rx178nwj/SteppingMotorDriver/firmware_test/param_design_notes.md

# パラメータ設計ノート

## 物理制約からの推定範囲

### 前提
- モータードライバ: DRV8825
- 電源: 24V
- 典型的なステッピングモーター: NEMA17 (200 steps/rev, 1.8°/step)
- RMT 解像度: 1 MHz (1 µs)

---

## マイクロステップと実回転速度

| マイクロステップ | steps/rev | 1000 steps/sec | 5000 steps/sec | 10000 steps/sec |
|:---:|---:|---:|---:|---:|
| 1/1  | 200 | 300 RPM | 1500 RPM | 3000 RPM |
| 1/2  | 400 | 150 RPM |  750 RPM | 1500 RPM |
| 1/4  | 800 |  75 RPM |  375 RPM |  750 RPM |
| 1/8  | 1600  |  37 RPM |  188 RPM |  375 RPM |
| 1/16 | 3200  |  19 RPM | 94 RPM |  188 RPM |
| 1/32 | 6400  | 9 RPM | 47 RPM | 94 RPM |

ロボットアーム用途の実用域: **10〜150 RPM** 前後

---

## マイクロステップ選択の指針

| 設定 | トルク | 滑らかさ | 共振リスク | 推奨用途 |
|---|:---:|:---:|:---:|---|
| 1/1  | ★★★★★ | ★ | 高い | 高トルク低速位置決め |
| 1/2  | ★★★★  | ★★ | 中 | |
| 1/4  | ★★★ | ★★★ | 中 | |
| 1/8  | ★★★ | ★★★★ | 低い | **バランス重視（推奨候補）** |
| 1/16 | ★★ | ★★★★★ | 低い | **静粛性重視（推奨候補）** |
| 1/32 | ★★ | ★★★★★ | 低い | 超低速精密動作 |

DRV8825 + 24V の場合、**1/8〜1/16** が実用的なトルク×スムーズさのバランス点。

---

## 最大速度 (vmax) の目安

ステッピングモーターは高速になるほどトルクが低下する。
24V 駆動の NEMA17 の場合、概ね以下の範囲で脱調リスクが増大する:

| マイクロステップ | 安全域 (低リスク) | 上限目安 | RMT 上限 |
|:---:|---:|---:|---:|
| 1/1  | ≤ 3000 steps/sec | 6000 | 200000 |
| 1/2  | ≤ 5000 steps/sec | 10000 | 200000 |
| 1/4  | ≤ 8000 steps/sec | 16000 | 200000 |
| 1/8  | ≤ 5000 steps/sec | 10000 | 200000 |
| 1/16 | ≤ 5000 steps/sec | 10000 | 200000 |
| 1/32 | ≤ 3000 steps/sec | 6000  | 200000 |

※ 実際のモーター仕様・負荷・電流設定により大きく変動する。スイープで実測すること。

---

## 加速度 (accel/decel) の目安

加速度が大きすぎると起動・停止時に脱調する。

```
必要ステップ数 = vmax² / (2 × accel)

例: vmax=2000, accel=1000 → 停止距離 = 2000² / (2×1000) = 2000 steps
```

| accel [steps/sec²] | vmax=1000 の加速距離 | vmax=5000 の加速距離 |
|---:|---:|---:|
| 200 | 2500 steps | 62500 steps |
| 500 | 1000 steps | 25000 steps |
| 1000  |  500 steps | 12500 steps |
| 2000  |  250 steps |  6250 steps |
| 5000  |  100 steps |  2500 steps |
| 10000 | 50 steps |  1250 steps |

加速距離が TEST_STEPS (3200) より大きい場合は三角プロファイルになる（最高速未達）。

---

## スイープテスト戦略

### Phase 1: マイクロステップ選択
```
accel=1000 固定, vmax=2000 固定
microstep を 1,2,4,8,16,32 で切り替えて動作音・振動を確認
```
→ 最も滑らかに動作するマイクロステップを選択

### Phase 2: 最大速度探索（選択したマイクロステップで）
```
python param_sweep.py COM3 --find-max-speed --microstep 16 --accel 1000
```
→ 脱調しない最大速度を確認

### Phase 3: 加速度最適化（選択した vmax で）
```
python param_sweep.py COM3 --quick
```
→ 最大速度で脱調しない最大加速度を確認

### Phase 4: NVS に保存
```
SET MICROSTEP 16
SET VMAX 0 <最大速度 × 0.8>   ← 安全マージン 20%
SET ACCEL 0 <最大加速度 × 0.8>
SET DECEL 0 <最大加速度 × 0.8>
SAVE
```

---

## 現在のデフォルト値

| パラメータ | デフォルト | ファームウェア上限 |
|---|---:|---:|
| vmax | 1000 steps/sec | 200000 |
| accel | 500 steps/sec² | (無制限) |
| decel | 500 steps/sec² | (無制限) |
| microstep | 1/32 | — |

デフォルトは保守的。実機テストで引き上げること。
