rx178nwj/SteppingMotorDriver/firmware/CODEX_PROMPT_BLE_PHASE5.md

# Codex 実装プロンプト — SteppingMotorDriver firmware BLE/WiFiテレメトリ Phase 5

## 役割
あなたは ESP-IDF（ESP32-S3）ファームウェアの実装・検証を担当するエンジニアです。
SteppingMotorDriver ファームウェアの無線テレメトリ機能 **Phase 5**（統合テスト：BLE/WiFi同時有効時の
coexistence評価、実機アンテナ性能評価）を、本リポジトリ内の要件定義書に厳密に従って実施してください。

**前提条件：Phase 2（BLEペアリング）・Phase 4（WiFi TCPテレメトリ）が完了していること。**
未完了の場合は着手せず、その旨を報告してください。

本Phaseは新機能の実装ではなく、**既存実装（Phase 1〜4）の検証・評価が中心**です。評価の結果、
リアルタイム性・安全性に影響する問題が見つかった場合のみ、最小限の修正を行ってください。

## 参照ドキュメント（正）
- `SteppingMotorDriver/firmware/BLE_WIFI_REQUIREMENTS.md` §7.1（安全性、最重要）・§7.3（無線共存）・
  §7.4（リアルタイム性）・§9.3（BLE/WiFi同時有効時の実機ジッタ許容量、未解決事項）・
  §9.5（筐体内アンテナ性能、未解決事項）
- `SteppingMotorDriver/firmware/REQUIREMENTS.md` §5.1（既存のリアルタイム性要件、モーション制御タスクの
  タイミング制約）
- 既存の統合テスト資産：`SteppingMotorDriver/firmware_test/`（既存105/106 PASSのテスト構成を参考に、
  同様の形式でBLE/WiFi統合テストケースを追加する）

## 今回のスコープ（Phase 5）
1. BLE/WiFi同時有効時のcoexistence評価（§7.3、§9.3の解消）
2. 実機アンテナ性能評価（§3、§9.5の解消）
3. 安全性の最終確認（§7.1：無線経由の書き込みコマンドが一切受理されないことの網羅的検証）
4. リアルタイム性の回帰確認（§7.4：BLE/WiFi有効化がモーション制御のタイミングに影響しないこと）

## Phase 5 実施要件（詳細）

### 4-A. coexistence評価（§7.3、§9.3）
- BLE・WiFi両方を同時有効化した状態で、以下を実機計測する：
  - BLE Notify（Axis Status、10Hz）の遅延・ジッタ・欠落率
  - WiFi TCPテレメトリ配信のレイテンシ・ジッタ・欠落率（配信レート1Hz/10Hz/100Hzでそれぞれ計測）
  - 既存のモーション制御タイミング（RMTパルス周期、`MotorControlTask`の1ms周期の遵守）に乱れがないか
- 典型運用として「BLEのみ」「WiFiのみ」「両方同時」の3パターンで比較し、許容可能なジッタ量を評価する。
- 評価結果を`BLE_WIFI_REQUIREMENTS.md` §9.3に追記し、未解決事項をクローズする（問題があれば推奨運用
  構成を明記する。両方同時有効化を禁止するかどうかもこの評価結果を根拠に判断する）。

### 4-B. アンテナ性能評価（§3、§9.5）
- 実機筐体（金属筐体・他基板との近接配置）でのBLE Advertising到達距離・WiFi RSSI・接続安定性を計測する。
- 評価結果を`BLE_WIFI_REQUIREMENTS.md` §9.5に追記し、未解決事項をクローズする（問題があれば筐体設計・
  アンテナ配置の改善提案を記録する。ハードウェア変更が必要な場合は本Phaseでは実施せず、課題として
  記録するのみでよい）。

### 4-C. 安全性の最終確認（§7.1、最重要・必須）
- BLE・WiFiいずれの経路からも、モーション制御・設定変更コマンドが一切受理されないことを網羅的に検証する：
  - BLE：書き込み可能なキャラクタリスティックが存在しないこと（CCCD以外）をGATTサービス定義から確認する
  - WiFi：TCP接続経由で送信したデータが一切コマンドとして解釈されないことを実機で確認する（Phase 4で
    実装済みのはずだが、本Phaseで独立した検証として再確認する）
  - ESTOPを含むモーション制御操作がBLE/WiFi経由で一切発行できないことを確認する
- この検証で問題が見つかった場合は**最優先で修正**すること（本Phaseの他の評価作業より優先する）。

### 4-D. リアルタイム性の回帰確認（§7.4）
- 既存の統合テスト（`firmware_test/`）が、BLE/WiFi有効化状態でも回帰なくPASSすることを確認する。
- モーション制御のタイミング（脱調検出、ホーミング精度等）にBLE/WiFiタスクが影響を与えていないことを
  既存テストケースの実行結果で確認する。

## 成果物
- coexistence評価・アンテナ性能評価の結果レポート（`BLE_WIFI_REQUIREMENTS.md` §9.3/§9.5への追記、
  未解決事項のクローズ）
- 評価で発見された問題への最小限の修正（あれば）
- 必要に応じて`firmware_test/`へのBLE/WiFi統合テストケース追加

## 完了条件（Definition of Done）
- BLE/WiFi同時有効時のcoexistence評価が完了し、推奨運用構成が`BLE_WIFI_REQUIREMENTS.md` §9.3に
  記録されている
- アンテナ性能評価が完了し、結果が§9.5に記録されている
- §7.1の安全性要件（無線経由の書き込みコマンド不受理）が実機で網羅的に確認されている
- 既存の統合テストが回帰なくPASSすることを確認している
- 実機評価ができない場合は、どこまで確認できたか・何が未確認かを明確に報告すること
