rx178nwj/SteppingMotorDriver/firmware_test/sweep_result_20260531_152136.csv

microstep | vmax | accel | passed | pos_error | elapsed_ms | note
8 | 500 | 500 | False | 0 | 0.0 | GET POS failed
8 | 500 | 1000 | False | 0 | 0.0 | GET POS failed
8 | 500 | 2000 | False | 0 | 0.0 | GET POS failed
8 | 500 | 5000 | False | 0 | 0.0 | GET POS failed
8 | 1000 | 500 | False | 0 | 0.0 | GET POS failed
8 | 1000 | 1000 | False | 0 | 0.0 | final GET POS failed
8 | 1000 | 2000 | False | 0 | 0.0 | GET POS failed
8 | 1000 | 5000 | False | 0 | 0.0 | GET POS failed
8 | 2000 | 500 | False | 0 | 0.0 | GET POS failed
8 | 2000 | 1000 | False | 0 | 0.0 | GET POS failed
8 | 2000 | 2000 | False | 0 | 0.0 | GET POS failed
8 | 2000 | 5000 | False | 0 | 0.0 | GET POS failed
8 | 5000 | 500 | False | 0 | 0.0 | final GET POS failed
8 | 5000 | 1000 | False | 0 | 0.0 | GET POS failed
8 | 5000 | 2000 | False | 0 | 0.0 | GET POS failed
8 | 5000 | 5000 | False | 0 | 0.0 | GET POS failed
8 | 10000 | 500 | False | 0 | 0.0 | GET POS failed
8 | 10000 | 1000 | False | 0 | 0.0 | GET POS failed
8 | 10000 | 2000 | False | 0 | 0.0 | GET POS failed
8 | 10000 | 5000 | False | 0 | 0.0 | GET POS failed
16 | 500 | 500 | False | 0 | 0.0 | GET POS failed
16 | 500 | 1000 | False | 0 | 0.0 | final GET POS failed
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
