rx178nwj/SteppingMotorDriver/(list of files, drawings)

Other design files:
schematic/SteppingMotorDriver.dsn
