rx178nwj/SteppingMotorDriver/(commit log)

2026-05-04 Initial KiCad stepper driver design
    [SteppingMotorDriver.kicad_pcb, SteppingMotorDriver.kicad_sch, adc_io.kicad_sch, drivers.kicad_sch, encoders_io.kicad_sch, mcu_usb.kicad_sch, power.kicad_sch]
2026-05-09 Refactor: reorganize into schematic/, firmware/, firmware_test/ structure
    [SteppingMotorDriver-B_Cu.gbr, SteppingMotorDriver-B_Mask.gbr, SteppingMotorDriver-B_Paste.gbr, SteppingMotorDriver-B_Silkscreen.gbr, SteppingMotorDriver-Edge_Cuts.gbr, SteppingMotorDriver-F_Cu.gbr, SteppingMotorDriver-F_Mask.gbr, SteppingMotorDriver-F_Paste.gbr]
2026-05-10 Add firmware skeleton and update schematic: DIP switch removed, MS lines GPIO-driven
    - MS0/MS1/MS2 now driven by ESP32-S3 GPIO (GPIO22/23/24) with 100Ω series resistors
    - Remove DIP switch from schematic plan and PCB
    - Add firmware scaffold: main, motor_ctrl, comm, config modules with sdkconfig
    - Add CLAUDE.md project instructions and .gitignore
    - Remove stale DRC/session files (SteppingMotorDriver.rules, .ses)
    [SteppingMotorDriver.kicad_pcb, mcu_usb.kicad_sch]
2026-05-30 Fix: move rmt_transmit() out of ISR context to prevent motor stall
    on_trans_done was calling rmt_transmit() from ISR, but rmt_transmit()
    internally uses xQueueSend() which is not ISR-safe. This caused only the
    first 5-pulse batch (RMT_LOOP_COUNT) to be sent, leaving the motor
    energized but stationary (humming).
    - on_trans_done: remove rmt_transmit() call; update step_pos only
    - motor_control_task: call rmt_kick() from task context every 1ms tick
    (trans_queue_depth=4 absorbs bursts; full-queue errors are ignored)
    - start_motion: reject motion if DRV not enabled (ENABLE not called)
    [motor_ctrl.c]
2026-06-19 Redesign schematic to 3ch: DRV8825x3, AM26LV32 differential encoder, swap ADC3/ADC4
    - DRV8825 stepper driver: 4ch -> 3ch (STEP/DIR CH0-2 on GPIO6-11)
    - Encoder: 3ch differential input via AM26LV32IDR for Stepperonline 17HS15-1504-ME1K (1000PPR)
    - A+/A-, B+/B-, Z+/Z- differential pairs, GPIO15-17/18/21/35/36-37/40
    - ADC assignment swap: GPIO4=MOT_V(ADC3) voltage monitor, GPIO5=CURRENT(ADC4) 100mOhm+20x amp
    - Updated Gerber files (Gerber202960613 replaces Gerber202960504)
    - Added AM26LV32IDR and AM26C32INSR library files
    - Updated REQUIREMENTS.md: 3ch axis range, encoder specs, ADC channel table, current conversion formula
    - Updated CLAUDE.md: corrected GPIO4/5 signal assignments and startup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
    [SteppingMotorDriver-B_Cu.gbr, SteppingMotorDriver-B_Mask.gbr, SteppingMotorDriver-B_Paste.gbr, SteppingMotorDriver-B_Silkscreen.gbr, SteppingMotorDriver-Edge_Cuts.gbr, SteppingMotorDriver-F_Cu.gbr, SteppingMotorDriver-F_Mask.gbr, SteppingMotorDriver-F_Paste.gbr]
2026-06-21 Add per-axis motor profile system with 17HS08/17HS15 specs and encoder constants
    Introduce motor_specs.h/c with motor_profile_t struct and motor_profile_id_t enum
    covering 17HS08-1004-ME1K (CH0, 1.0A, 120mNm) and 17HS15-1504-ME1K (CH1/CH2,
    1.5A, 400mNm). Each profile holds physical params, torque curve approximation,
    recommended vmax/accel/decel, and ME1K encoder constants (1000 PPR, 4000
    counts/rev after PCNT 4x). config.c persists the per-axis profile ID to NVS
    ("mprof0/1/2") and exposes config_set/get_motor_profile() API for runtime
    switching; changing a profile immediately applies its default vmax/accel/decel.
2026-06-21 Add homing/fault state machine, improved error codes, and board test firmware
    - motor_ctrl: add AXIS_HOMING state, fault_reason_t, per-axis move-done/fault callbacks
    - comm: HOMING state name, fault event reporting (EVT FAULT), E006/E008 error codes for MOVE
    - gpio_config: update GPIO assignments for 3ch layout
    - main: remove stale comment
    - schematic/power.kicad_sch: minor net updates
    - firmware_test: add board_test.c, CMakeLists, sdkconfig, test_initial_check.py
    [power.kicad_sch]
2026-06-21 Add Phase 4 ADC monitoring: LT6106 current sense, voltage monitor, overcurrent protection
    - adc_monitor.c/h: ADCTask (priority 15, 10ms) with 5ch oneshot sampling
    - 4x oversampling per channel with moving average filter (ring buffer, N=1-64)
    - ADC calibration via adc_cali_create_scheme_curve_fitting (ESP32-S3)
    - Current sense (CH4/GPIO5): LT6106 with 10mΩ shunt, Rin=120Ω, Rout=5kΩ
    I[mA] = V_adc[mV] × 2.4 (corrected from REQUIREMENTS which assumed 100mΩ×20x)
    - Motor voltage (CH3/GPIO4): V_mot[V] = V_adc[V] × divider_ratio (default 24/3.3)
    - Overcurrent protection: motor_estop(FAULT_OVERCURRENT) with hysteresis latch
    - comm.c: GET ADC <ch>, SET ADC_FILTER, SET CURRENT_LIMI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
    [adc_monitor.c, adc_monitor.h, comm.c, encoder.c, encoder.h, main.c, motor_ctrl.c, motor_ctrl.h]
2026-06-21 Add Phase 5: SYNC_MOVE, StatusTask, and full NVS parameter persistence
    - motor_ctrl.c/h: Implement SYNC_MOVE (F-MOT-11) — multi-axis synchronized
    motion with duration-matching speed scaling. Reference axis (max |steps|)
    keeps its v_max/accel/decel; slave axes scaled by ratio. All RMT channels
    start atomically in the same MotorControlTask 1ms tick via sync_pending flag.
    Soft limit, STOP on sync axis, and ESTOP all abort the group with
    EVT SYNC_ABORTED. Normal completion fires EVT SYNC_DONE.
    - comm.c: Add SYNC_MOVE command parser (strtol-based, handles duplicate-axis,
    range, and IDLE checks), HEARTBEAT ON/OFF command, StatusTask (100ms,
    outputs compact HB line when enabled), an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
2026-06-23 Fix SYNC_MOVE profile contamination
    [comm.c, config.c, motor_ctrl.c, motor_ctrl.h, test_initial_check.py]
2026-07-19 Add monitor app requirements spec; ignore build/cache artifacts
    Also picks up KiCad zone-settings auto-update in the .kicad_pro file.
2026-07-19 Add monitor app requirements and board ID via factory MAC address
    Create monitor_app/REQUIREMENTS.md for the Electron-based multi-board
    monitoring/control app. Add F-COM-05 (GET BOARD_ID command, USB
    iSerialNumber, E012 error) to firmware requirements so the host app can
    identify boards by ESP32-S3 factory MAC instead of COM port number,
    which is unstable across reconnects when running multiple boards.
2026-07-25 Add gear output angle monitor firmware and Electron monitor app scaffold
    Gear monitor tracks output-shaft angle (offset/dir/ratio, NVS-persisted
    per axis) alongside the existing step-driven position. The monitor_app
    gains its first Electron/Node implementation (main process, renderer,
    trend charts, tests) per REQUIREMENTS.md Phase 1-3.
2026-07-26 Clarify USB board identification edge cases in monitor_app requirements
    Adds VID/PID pre-filtering to F-CONN-01 (mirrors robot_arm_monitor's
    VID_HINT pattern) and resolves two unspecified behaviors in F-CONN-06:
    serialNumber/BOARD_ID mismatch handling (trust BOARD_ID, warn, don't
    block) and the E012 fallback's lack of persistent auto-mapping.
2026-08-01 Fix BLE pairing and Windows discoverability for telemetry advertising
    - Add shortened device name to the primary advertising PDU so
    Windows' Bluetooth "Add device" scan (which often skips the scan
    response) can identify the board; full name stays in the scan
    response.
    - Disable SC-only security mode: it required MITM-authenticated
    level 4 links, which Just Works pairing (no I/O capability) can
    never satisfy, so Windows pairing was silently rejected.
    - Delete stale bonds and log GAP/security events on pairing or
    encryption failure to recover cleanly instead of leaving Windows
    with an unusable ghost bond.
    Verified on real hardware: Windows pairing succeeds and
    robot_arm_monitor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
    [ble_telemetry.c]
2026-08-02 Add status LED support, Multiplexer schematic, and Gerber export
    Adds status_led.c/h for GPIO46/47 LED indicators, a Multiplexer
    schematic sheet, exported Gerber fabrication files, and BLE Codex
    prompt docs. Removes stale KiCad auto-backup zips.
    [Multiplexer.kicad_sch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]
2026-08-13 Add hold-current mode, joint-angle calibration, error logging, and VMAX/ACCEL/DECEL GET commands
    Adds F-MOT-13 hold-current mode (NORMAL/FULL/REDUCED via DRV_EN PWM
    chopping), F-MOT-12 joint-angle/POT calibration config, an in-firmware
    error log ring buffer (error_log.c/h, GET LOG / LOG_CLEAR), and
    individual GET VMAX/GET ACCEL/GET DECEL commands so hosts no longer
    need to parse the bundled STATUS JSON to read motion profile values.
    Updates monitor_app, firmware_test, and requirements docs accordingly.
    [adc_monitor.c, adc_monitor.h, ble_telemetry.c, comm.c, config.c, config.h, error_log.c, error_log.h]
2026-08-13 Add per-channel motor type (encoder vs. encoderless) selection
    Some joints use closed-loop steppers with encoders while others are
    open-loop, so stall detection, Z-phase homing, and encoder PCNT/GPIO
    init now key off a new per-axis MOTOR_TYPE setting (SET/GET MOTOR_TYPE,
    NVS-persisted). Open-loop axes home against the multi_i2c_bridge
    (AS5600) absolute angle instead of a Z-phase index search, and encoder
    GET commands are rejected for them. Also fixes a latent bug where
    GET ENC_DEG/BLE JOINT_ANGLE failed for all axes if any single axis had
    no encoder PPR configured.
    [comm.c, config.c, encoder.c, main.c, motor_ctrl.c, motor_ctrl.h, telemetry.c]
2026-08-16 Add per-axis driver_type for external TB6600 driver support (F-MOT-15)
    CH0 now drives a high-power 23HS8430D motor via an external TB6600 driver
    (3.3V->5V level shift + optocoupler) instead of the onboard DRV8825.
    The optocoupler wiring inverts STEP/DIR polarity and flips the shared
    DRV_EN active level, so driver_type is tracked per axis (SET/GET
    DRIVER_TYPE, NVS-persisted) and the shared enable line switches to
    active-high whenever any axis uses an external driver.
    [comm.c, config.c, motor_ctrl.c, motor_ctrl.h]
